silverXnoise/smartknob/electronics/view_base/view_base-front3D.jpg

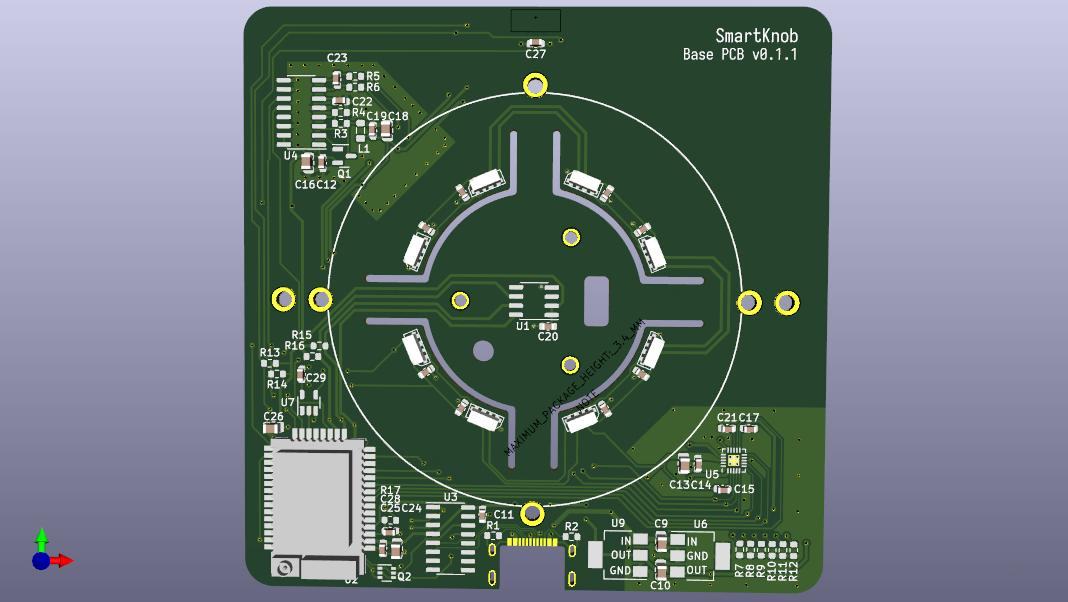
electronics/view_base/view_base-front3D.jpg
