silverXnoise/smartknob/electronics/view_base/view_base-back3D.jpg

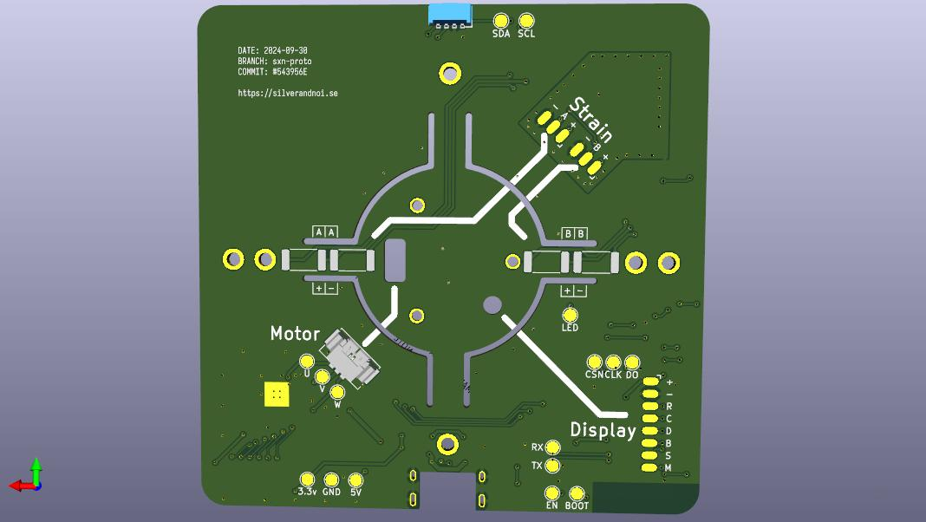
electronics/view_base/view_base-back3D.jpg
