silverXnoise/smartknob/electronics/docs/img/Screenshot 2024-10-25 004248.png

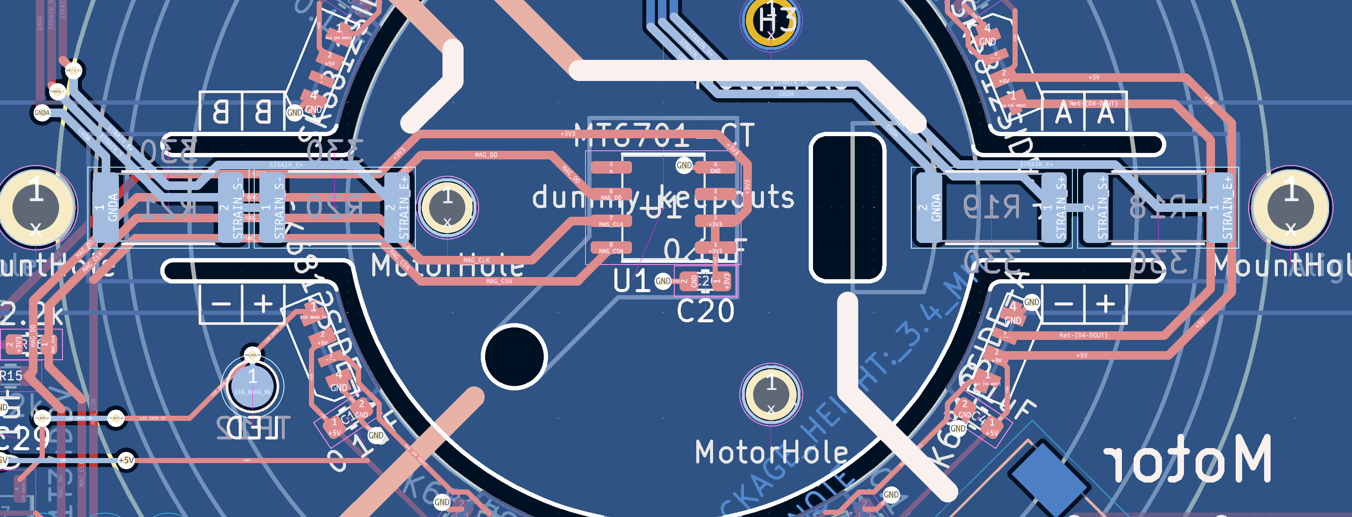
electronics/docs/img/Screenshot 2024-10-25 004248.png
