silverXnoise/smartknob/electronics/LevelShifterBreakout/production/bom.csv

Designator | Footprint | Quantity | Value | LCSC Part #
C1, C2 | 0805 | 2 | 0.1uF
J1, J2 | PinHeader_1x08_P2.54mm_Vertical | 2 | Conn_01x08_Male
U1 | Texas_Instruments-RSV_R-PUQFN-N16-0-0-0 | 1 | SN74AVC4T774RSVR
