silverXnoise/smartknob/electronics/view_base/Print Schematic.pdf

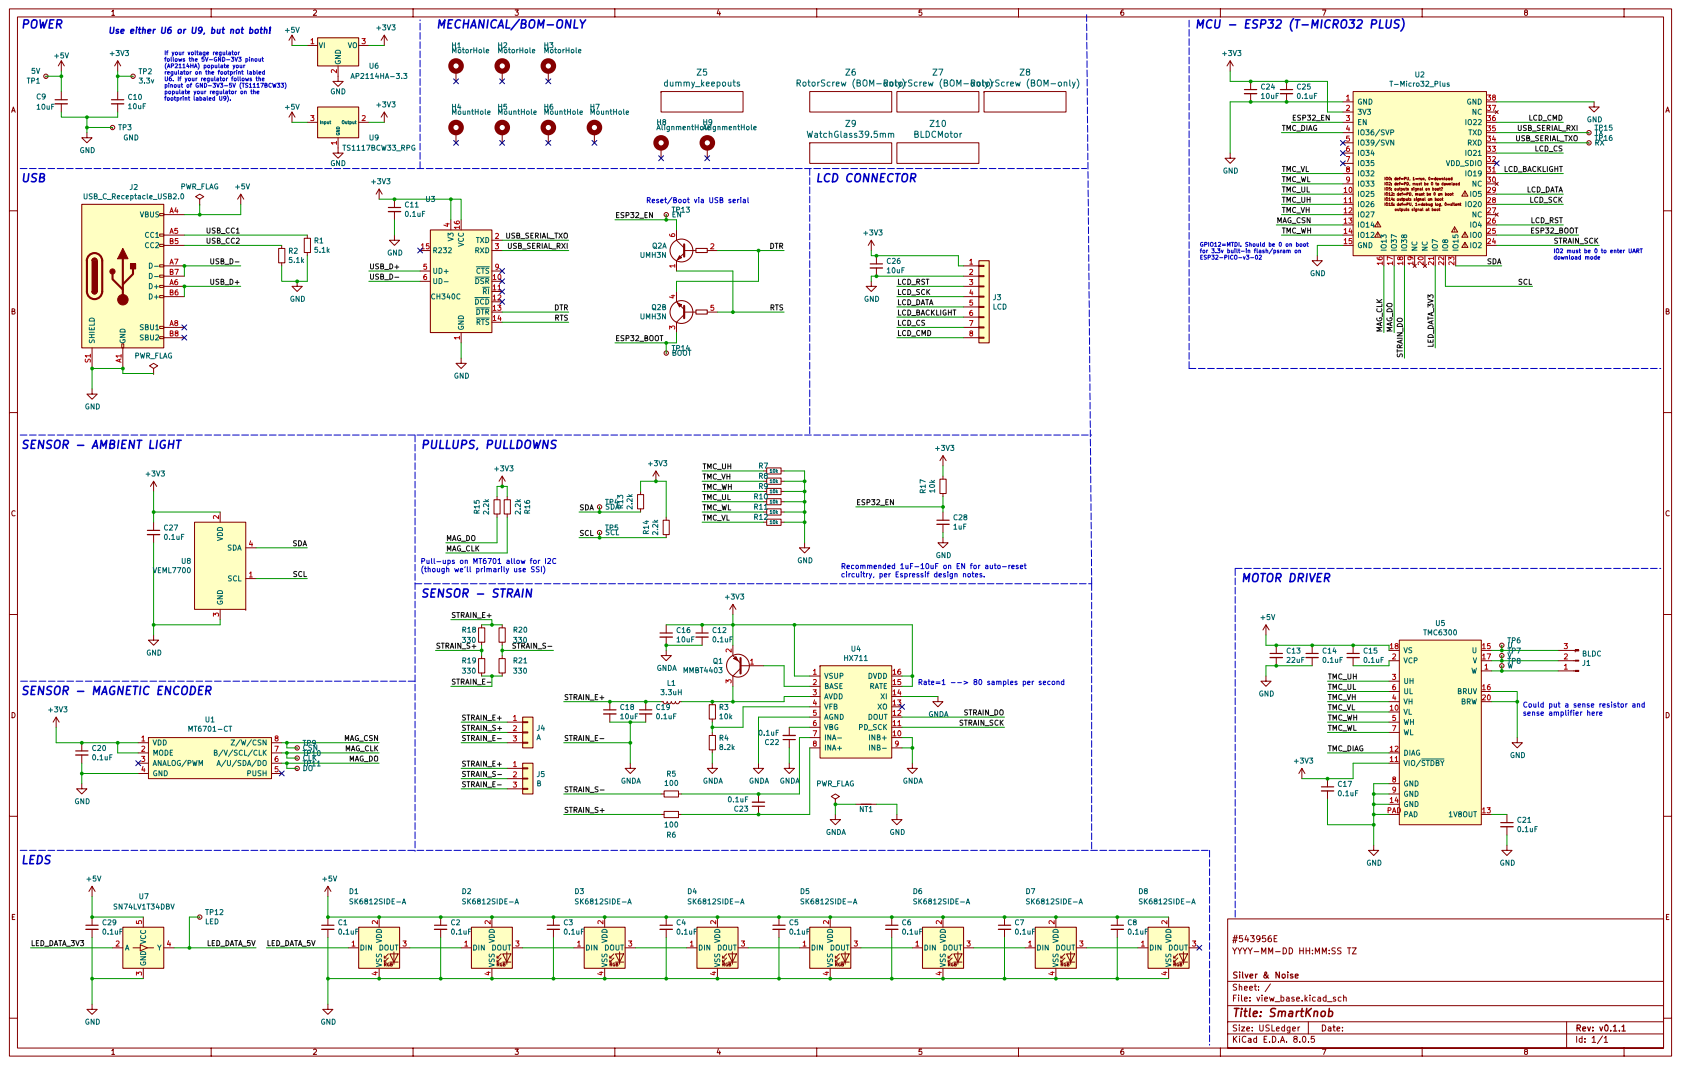
[picture p4: page 1]
