silverXnoise/smartknob/electronics/LevelShifterBreakout/LevelShifterBreakout.kicad_pcb

## KiCad design electronics/LevelShifterBreakout/LevelShifterBreakout.kicad_pcb (2024-09-27)


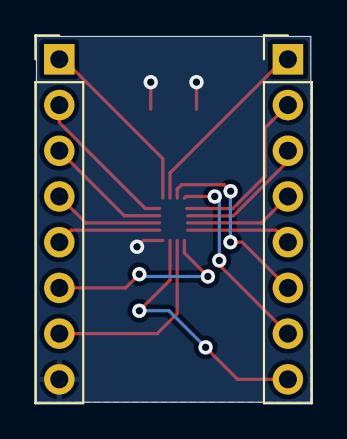
[picture p14: board LevelShifterBreakout.kicad_pcb from below]

Board: 2 copper layers, 15.2 x 20.3 mm, 5 parts (2 on the bottom side), 16 nets.

Parts:
C1, C2: 0.1uF; C_0805_2012Metric_Pad1.18x1.45mm_HandSolder
J1, J2: Conn_01x08_Male; PinHeader_1x08_P2.54mm_Vertical
U1: SN74AVC4T774RSVR; Texas_Instruments-RSV_R-PUQFN-N16-0-0-0

Connections:
/A1: J1.2, U1.1
/A2: J1.3, U1.2
/A3: J1.4, U1.3
/A4: J1.5, U1.4
/B1: J2.2, U1.12
/B2: J2.3, U1.11
/B3: J2.4, U1.10
/B4: J2.5, U1.9
/DIR1: J1.6, U1.15
/DIR2: J1.7, U1.16
/DIR3: J2.6, U1.5
/DIR4: J2.7, U1.6
/VCCA: C1.1, J1.1, U1.14
/VCCB: C2.1, J2.1, U1.13
/nOE: J1.8, U1.7
GND: C1.2, C2.2, J2.8, U1.8
