silverXnoise/smartknob/(commit log)

2023-05-09 Added moldule
2024-09-27 Updated project info
    [view_base.kicad_pcb, view_base.kicad_sch]
2024-09-27 Updated project
    [view_base.kicad_pcb]
2024-09-27 Updated project vars
    [view_base.kicad_pcb]
2024-09-27 Update view_base.kicad_pcb and view_base.kicad_pro
    [view_base.kicad_pcb]
2024-09-27 Added branch var view_base.kicad_pcb and view_base.kicad_pro
    [view_base.kicad_pcb]
2024-09-27 Generated gerbers
    [BM28B0.6-24DSBreakout.kicad_pcb, BM28B0.6-24DSBreakout.kicad_sch, LevelShifterBreakout.kicad_pcb, bom.csv, designators.csv, positions.csv, view_base.kicad_pcb, view_screen.kicad_pcb]
2024-10-25 Added gerbers and img
    [view_base.csv]
